JuanDLemus/Agrar-Smart-Greenhouse/(commit log)

2025-11-24 Create Corte3.md for smart greenhouse system
    Added comprehensive documentation for an ESP32-based smart greenhouse system, detailing design, implementation, and experimental results.
2025-11-24 Fix image link format in Corte3.md
    Updated image link format in Corte3.md for prototype assembly.
